dcharles2001/OSS/README.md

# OSS
Open Source Security Project

Project Contributors:
Ethan Barrett
Daniel Charles
Thomas Stinton
Jason Hoare
