dcharles2001/OSS/Meeting Minutes/Lab4.docx

Lab4:

Group Name: Open-Source Security (OSS)

Group Members: Ethan Barrett, Daniel Charles, Jason Hoare, Thomas Stinton

Project: Security System

Ethan – Added single double encryption improvements. Functionality improvements

Dan/Tom – 3D Node 2 shroud, continuation work on node 2 circuitry and coding

Jason – N/A
